arista/ultranetMonitor/ui-tile-1/ui-tile-kicad/ui-tile-kicad.kicad_pcb

## KiCad design ui-tile-1/ui-tile-kicad/ui-tile-kicad.kicad_pcb (2026-06-21)

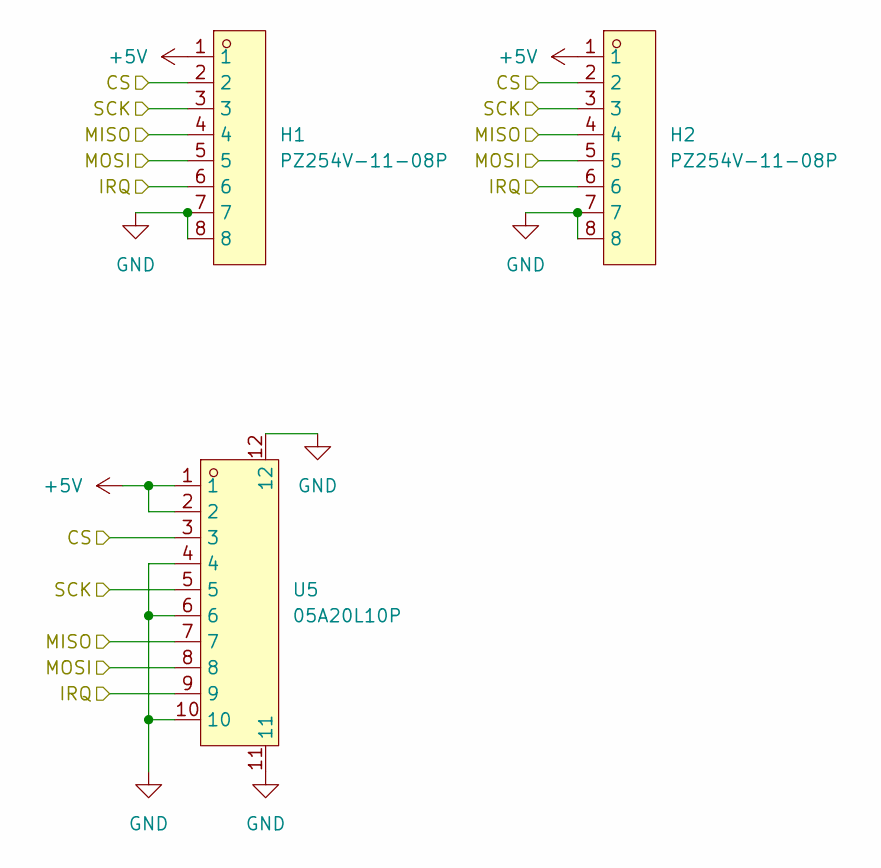
[picture p1: schematic headers.kicad_sch]

Parts:
H1, H2: PZ254V-11-08P; HDR-TH_8P-P2.54-V-M; MPN PZ254V-11-08P; LCSC Part C492407
U5: 05A20L10P; FPC-SMD_10P-P0.50_05A20L10P; MPN 05A20L10P; LCSC Part C5362154

Connections:
+5V: H1.1, H2.1, U5.1, U5.2; also elsewhere on the board
/headers/CS: H1.2, H2.2, U5.3; also elsewhere on the board
/headers/IRQ: H1.6, H2.6, U5.9; also elsewhere on the board
/headers/MISO: H1.4, H2.4, U5.7; also elsewhere on the board
/headers/MOSI: H1.5, H2.5, U5.8; also elsewhere on the board
/headers/SCK: H1.3, H2.3, U5.5; also elsewhere on the board
GND: H1.7, H1.8, H2.7, H2.8, U5.4, U5.6, U5.10, U5.11, U5.12; also elsewhere on the board

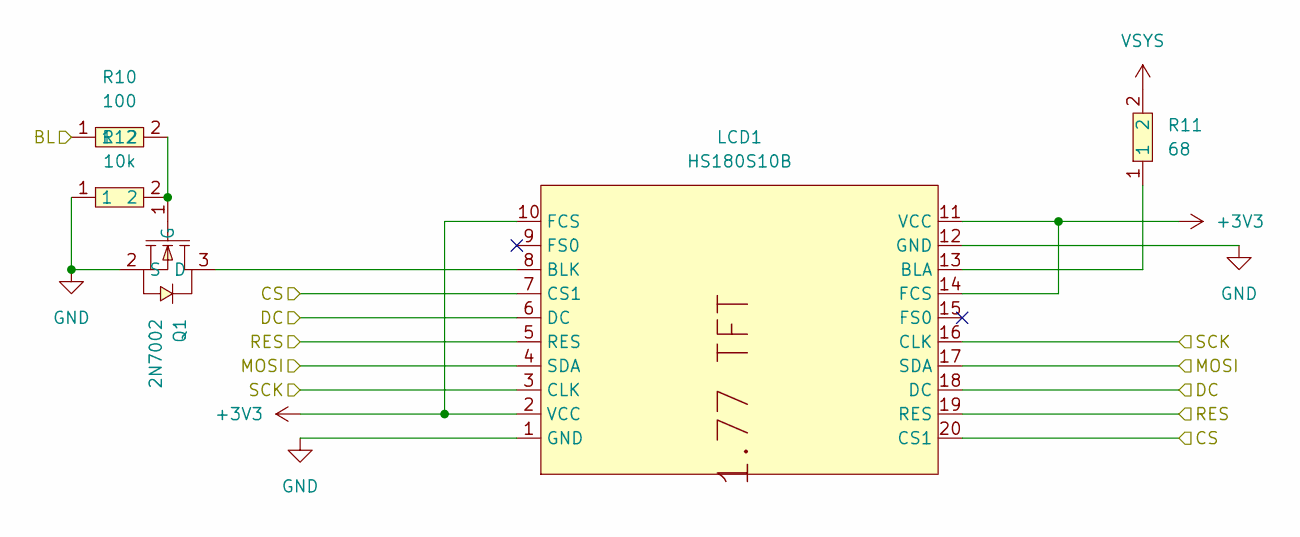
[picture p2: schematic lcd.kicad_sch]

Parts:
LCD1: HS180S10B; LCD-TH_L56.0-W35.0-P2.54_HS180S10B; MPN HS180S10B; LCSC Part C5329585
Q1: 2N7002; SOT-23-3_L2.9-W1.3-P1.90-LS2.4-BR; MPN 2N7002; LCSC Part C8545
R10: 100; R0402; MPN 0402WGF1000TCE; LCSC Part C25076
R11: 68; R0603; MPN 0603WAF680JT5E; LCSC Part C27592
R12: 10k; R0402; MPN 0402WGF1002TCE; LCSC Part C25744

Connections:
+3V3: LCD1.2 (VCC), LCD1.10 (FCS), LCD1.11 (VCC), LCD1.14 (FCS); also elsewhere on the board
/lcd/BL: R10.1; also elsewhere on the board
/lcd/CS: LCD1.7 (CS1), LCD1.20 (CS1); also elsewhere on the board
/lcd/DC: LCD1.6 (DC), LCD1.18 (DC); also elsewhere on the board
/lcd/MOSI: LCD1.4 (SDA), LCD1.17 (SDA); also elsewhere on the board
/lcd/RES: LCD1.5 (RES), LCD1.19 (RES); also elsewhere on the board
/lcd/SCK: LCD1.3 (CLK), LCD1.16 (CLK); also elsewhere on the board
GND: LCD1.1 (GND), LCD1.12 (GND), Q1.2 (S), R12.1; also elsewhere on the board
unnamed: LCD1.13 (BLA), R11.1
unnamed: LCD1.8 (BLK), Q1.3 (D)
unnamed: Q1.1 (G), R10.2, R12.2
VSYS: R11.2; also elsewhere on the board

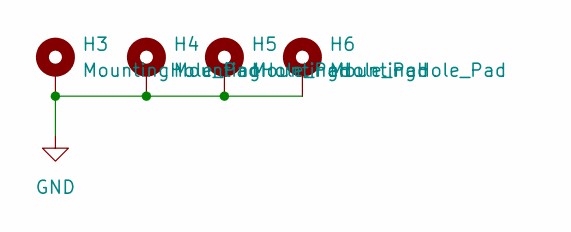
[picture p3: schematic mounting_holes.kicad_sch]

Parts:
H3, H4, H5, H6: MountingHole_Pad; MountingHole_3.2mm_M3_Pad

Connections:
GND: H3.1 (1_1), H4.1 (1_1), H5.1 (1_1), H6.1 (1_1); also elsewhere on the board

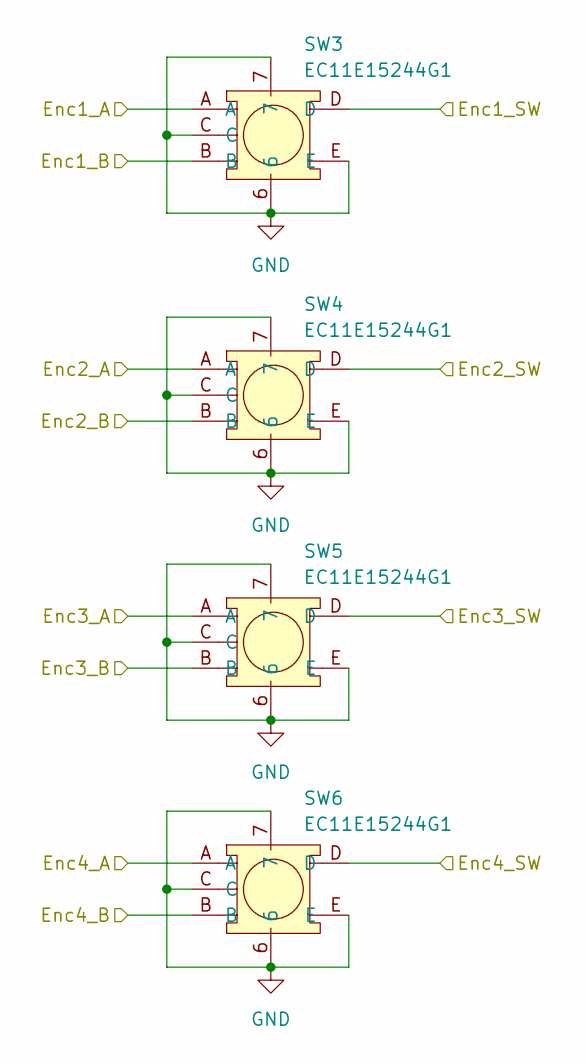
[picture p4: schematic encoders.kicad_sch]

Parts:
SW3, SW4, SW5, SW6: EC11E15244G1; SW-TH_EC11E15244G1; MPN EC11E15244G1; LCSC Part C370970

Connections:
/encoders/Enc1_A: SW3.A; also elsewhere on the board
/encoders/Enc1_B: SW3.B; also elsewhere on the board
/encoders/Enc1_SW: SW3.D; also elsewhere on the board
/encoders/Enc2_A: SW4.A; also elsewhere on the board
/encoders/Enc2_B: SW4.B; also elsewhere on the board
/encoders/Enc2_SW: SW4.D; also elsewhere on the board
/encoders/Enc3_A: SW5.A; also elsewhere on the board
/encoders/Enc3_B: SW5.B; also elsewhere on the board
/encoders/Enc3_SW: SW5.D; also elsewhere on the board
/encoders/Enc4_A: SW6.A; also elsewhere on the board
/encoders/Enc4_B: SW6.B; also elsewhere on the board
/encoders/Enc4_SW: SW6.D; also elsewhere on the board
GND: SW3.6, SW3.7, SW3.C, SW3.E, SW4.6, SW4.7, SW4.C, SW4.E, SW5.6, SW5.7, SW5.C, SW5.E, SW6.6, SW6.7, SW6.C, SW6.E; also elsewhere on the board

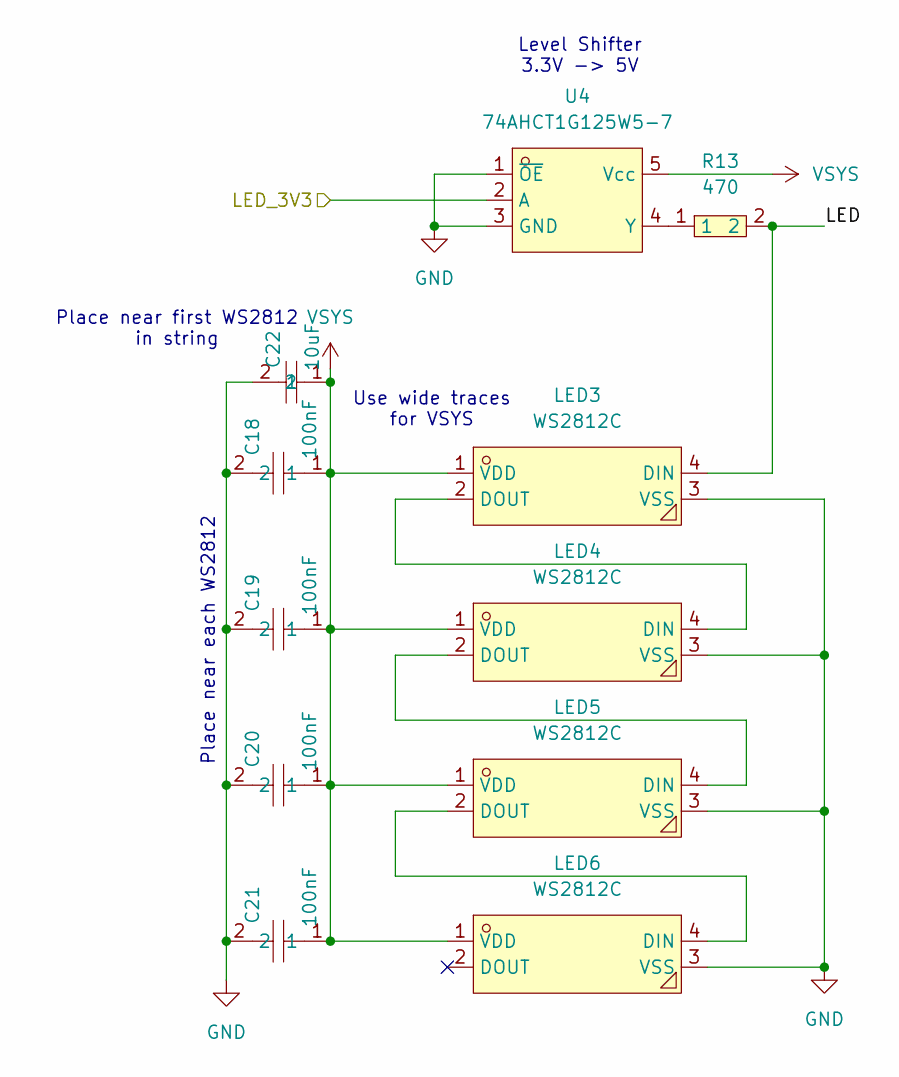
[picture p5: schematic leds.kicad_sch]

Parts:
C18, C19, C20, C21: 100nF; C0402; MPN CL05B104KO5NNNC; LCSC Part C1525
C22: 10uF; C0805; MPN CL21A106KOQNNNE; LCSC Part C1713
LED3, LED4, LED5, LED6: WS2812C; LED-SMD_4P-L5.0-W5.0-LS5.4-TL-1; MPN WS2812C; LCSC Part C114587
R13: 470; R0402; MPN 0402WGF4700TCE; LCSC Part C25117
U4: 74AHCT1G125W5-7; SOT-25-5_L3.0-W1.6-P0.95-LS2.8-BL; MPN 74AHCT1G125W5-7; LCSC Part C842287

Connections:
/leds/LED: LED3.4 (DIN), R13.2
/leds/LED_3V3: U4.2 (A); also elsewhere on the board
GND: C18.2, C19.2, C20.2, C21.2, C22.2, LED3.3 (VSS), LED4.3 (VSS), LED5.3 (VSS), LED6.3 (VSS), U4.1 (~OE), U4.3 (GND); also elsewhere on the board
unnamed: LED3.2 (DOUT), LED4.4 (DIN)
unnamed: LED4.2 (DOUT), LED5.4 (DIN)
unnamed: LED5.2 (DOUT), LED6.4 (DIN)
unnamed: R13.1, U4.4 (Y)
VSYS: C18.1, C19.1, C20.1, C21.1, C22.1, LED3.1 (VDD), LED4.1 (VDD), LED5.1 (VDD), LED6.1 (VDD), U4.5 (Vcc); also elsewhere on the board

Notes on the sheet:
Place near first WS2812 in string
Place near each WS2812
Use wide traces for VSYS
Level Shifter 3.3V -> 5V

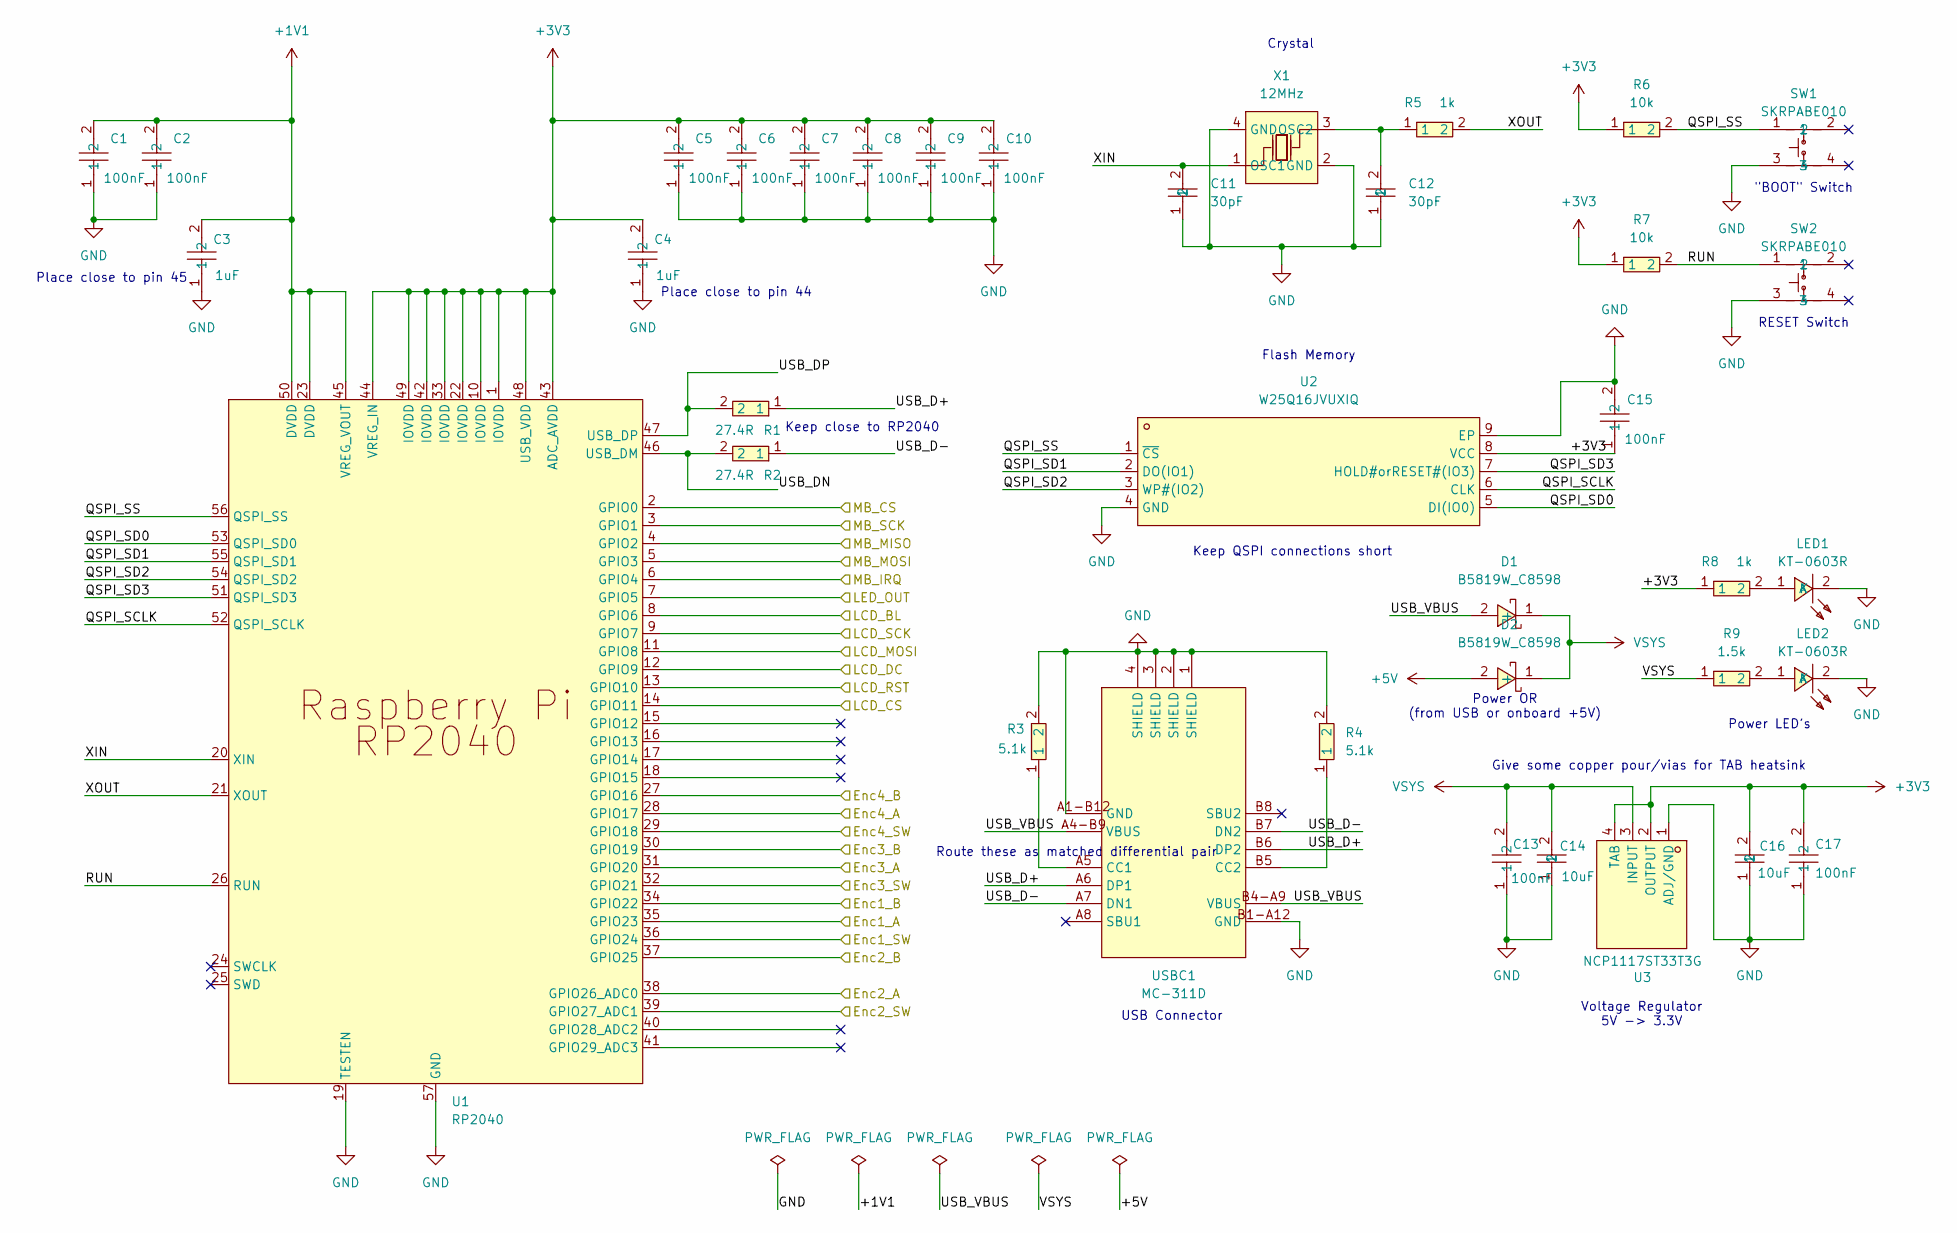
[picture p6: schematic rp2040.kicad_sch]

Parts:
C1, C2, C5, C6, C7, C8, C9, C10, C13, C15, C17: 100nF; C0402; MPN CL05B104KO5NNNC; LCSC Part C1525
C3, C4: 1uF; C0402; MPN CL05A105KA5NQNC; LCSC Part C52923
C11, C12: 30pF; C0402; MPN 0402CG300J500NT; LCSC Part C1570
C14, C16: 10uF; C0805; MPN CL21A106KOQNNNE; LCSC Part C1713
D1, D2: B5819W_C8598; SOD-123_L2.7-W1.6-LS3.7-RD-1; MPN B5819W SL; LCSC Part C8598
LED1, LED2: KT-0603R; LED-SMD_L1.6-W0.8-R-RD; MPN KT-0603R; LCSC Part C2286
R1, R2: 27.4R; R0402; MPN 0402WGF274JTCE; LCSC Part C31439
R3, R4: 5.1k; R0402; MPN 0402WGF5101TCE; LCSC Part C25905
R5, R8: 1k; R0402; MPN 0402WGF1001TCE; LCSC Part C11702
R6, R7: 10k; R0402; MPN 0402WGF1002TCE; LCSC Part C25744
R9: 1.5k; R0603; MPN 0603WAF1501T5E; LCSC Part C22843
SW1, SW2: SKRPABE010; KEY-SMD_4P-L4.2-W3.2-P2.20-LS4.6; MPN SKRPABE010; LCSC Part C115360
U1: RP2040; LQFN-56_L7.0-W7.0-P0.4-EP; MPN RP2040; LCSC Part C2040
U2: W25Q16JVUXIQ; USON-8_L3.0-W2.0-P0.50-BL-EP; MPN W25Q16JVUXIQ; LCSC Part C2843335
U3: NCP1117ST33T3G; SOT-223-3_L6.5-W3.4-P2.30-LS7.0-BR; MPN NCP1117ST33T3G; LCSC Part C26537
USBC1: MC-311D; USB-C-SMD_MC-311D; MPN MC-311D; LCSC Part C136423
X1: 12MHz; CRYSTAL-SMD_4P-L3.2-W2.5-BL; MPN X322512MSB4SI; LCSC Part C9002

Connections:
+1V1: C1.2, C2.2, C3.2, U1.23 (DVDD), U1.45 (VREG_VOUT), U1.50 (DVDD)
+3V3: C4.2, C5.2, C6.2, C7.2, C8.2, C9.2, C10.2, C15.1, C16.2, C17.2, R6.1, R7.1, R8.1, U1.1 (IOVDD), U1.10 (IOVDD), U1.22 (IOVDD), U1.33 (IOVDD), U1.42 (IOVDD), U1.43 (ADC_AVDD), U1.44 (VREG_IN), U1.48 (USB_VDD), U1.49 (IOVDD), U2.8 (VCC), U3.2 (OUTPUT), U3.4 (TAB); also elsewhere on the board
+5V: D2.2 (+); also elsewhere on the board
/encoders/Enc1_A: U1.35 (GPIO23); also elsewhere on the board
/encoders/Enc1_B: U1.34 (GPIO22); also elsewhere on the board
/encoders/Enc1_SW: U1.36 (GPIO24); also elsewhere on the board
/encoders/Enc2_A: U1.38 (GPIO26_ADC0); also elsewhere on the board
/encoders/Enc2_B: U1.37 (GPIO25); also elsewhere on the board
/encoders/Enc2_SW: U1.39 (GPIO27_ADC1); also elsewhere on the board
/encoders/Enc3_A: U1.31 (GPIO20); also elsewhere on the board
/encoders/Enc3_B: U1.30 (GPIO19); also elsewhere on the board
/encoders/Enc3_SW: U1.32 (GPIO21); also elsewhere on the board
/encoders/Enc4_A: U1.28 (GPIO17); also elsewhere on the board
/encoders/Enc4_B: U1.27 (GPIO16); also elsewhere on the board
/encoders/Enc4_SW: U1.29 (GPIO18); also elsewhere on the board
/headers/CS: U1.2 (GPIO0); also elsewhere on the board
/headers/IRQ: U1.6 (GPIO4); also elsewhere on the board
/headers/MISO: U1.4 (GPIO2); also elsewhere on the board
/headers/MOSI: U1.5 (GPIO3); also elsewhere on the board
/headers/SCK: U1.3 (GPIO1); also elsewhere on the board
/lcd/BL: U1.8 (GPIO6); also elsewhere on the board
/lcd/CS: U1.14 (GPIO11); also elsewhere on the board
/lcd/DC: U1.12 (GPIO9); also elsewhere on the board
/lcd/MOSI: U1.11 (GPIO8); also elsewhere on the board
/lcd/RES: U1.13 (GPIO10); also elsewhere on the board
/lcd/SCK: U1.9 (GPIO7); also elsewhere on the board
/leds/LED_3V3: U1.7 (GPIO5); also elsewhere on the board
/rp2040/QSPI_SCLK: U1.52 (QSPI_SCLK), U2.6 (CLK)
/rp2040/QSPI_SD0: U1.53 (QSPI_SD0), U2.5 (DI(IO0))
/rp2040/QSPI_SD1: U1.55 (QSPI_SD1), U2.2 (DO(IO1))
/rp2040/QSPI_SD2: U1.54 (QSPI_SD2), U2.3 (WP#(IO2))
/rp2040/QSPI_SD3: U1.51 (QSPI_SD3), U2.7 (HOLD#orRESET#(IO3))
/rp2040/QSPI_SS: R6.2, SW1.1, U1.56 (QSPI_SS), U2.1 (~CS)
/rp2040/RUN: R7.2, SW2.1, U1.26 (RUN)
/rp2040/USB_D+: R1.1, USBC1.A6 (DP1), USBC1.B6 (DP2)
/rp2040/USB_D-: R2.1, USBC1.A7 (DN1), USBC1.B7 (DN2)
/rp2040/USB_DN: R2.2, U1.46 (USB_DM)
/rp2040/USB_DP: R1.2, U1.47 (USB_DP)
/rp2040/USB_VBUS: D1.2 (+), USBC1.A4-B9 (VBUS), USBC1.B4-A9 (VBUS)
/rp2040/XIN: C11.2, U1.20 (XIN), X1.1 (OSC1)
/rp2040/XOUT: R5.2, U1.21 (XOUT)
GND: C1.1, C2.1, C3.1, C4.1, C5.1, C6.1, C7.1, C8.1, C9.1, C10.1, C11.1, C12.1, C13.1, C14.1, C15.2, C16.1, C17.1, LED1.2 (K), LED2.2 (K), R3.2, R4.2, SW1.3, SW2.3, U1.19 (TESTEN), U1.57 (GND), U2.4 (GND), U2.9 (EP), U3.1 (ADJ/GND), USBC1.1 (SHIELD), USBC1.2 (SHIELD), USBC1.3 (SHIELD), USBC1.4 (SHIELD), USBC1.A1-B12 (GND), USBC1.B1-A12 (GND), X1.2 (GND), X1.4 (GND); also elsewhere on the board
unnamed: LED1.1 (A), R8.2
unnamed: LED2.1 (A), R9.2
unnamed: R3.1, USBC1.A5 (CC1)
unnamed: R4.1, USBC1.B5 (CC2)
unnamed: C12.2, R5.1, X1.3 (OSC2)
VSYS: C13.2, C14.2, D1.1 (-), D2.1 (-), R9.1, U3.3 (INPUT); also elsewhere on the board

Notes on the sheet:
Route these as matched differential pair
Give some copper pour/vias for TAB heatsink
Crystal
RESET Switch
"BOOT" Switch
Flash Memory
Place close to pin 45
Voltage Regulator 5V -> 3.3V
Keep QSPI connections short
Keep close to RP2040
Power LED's
Power OR (from USB or onboard +5V)
USB Connector
Place close to pin 44

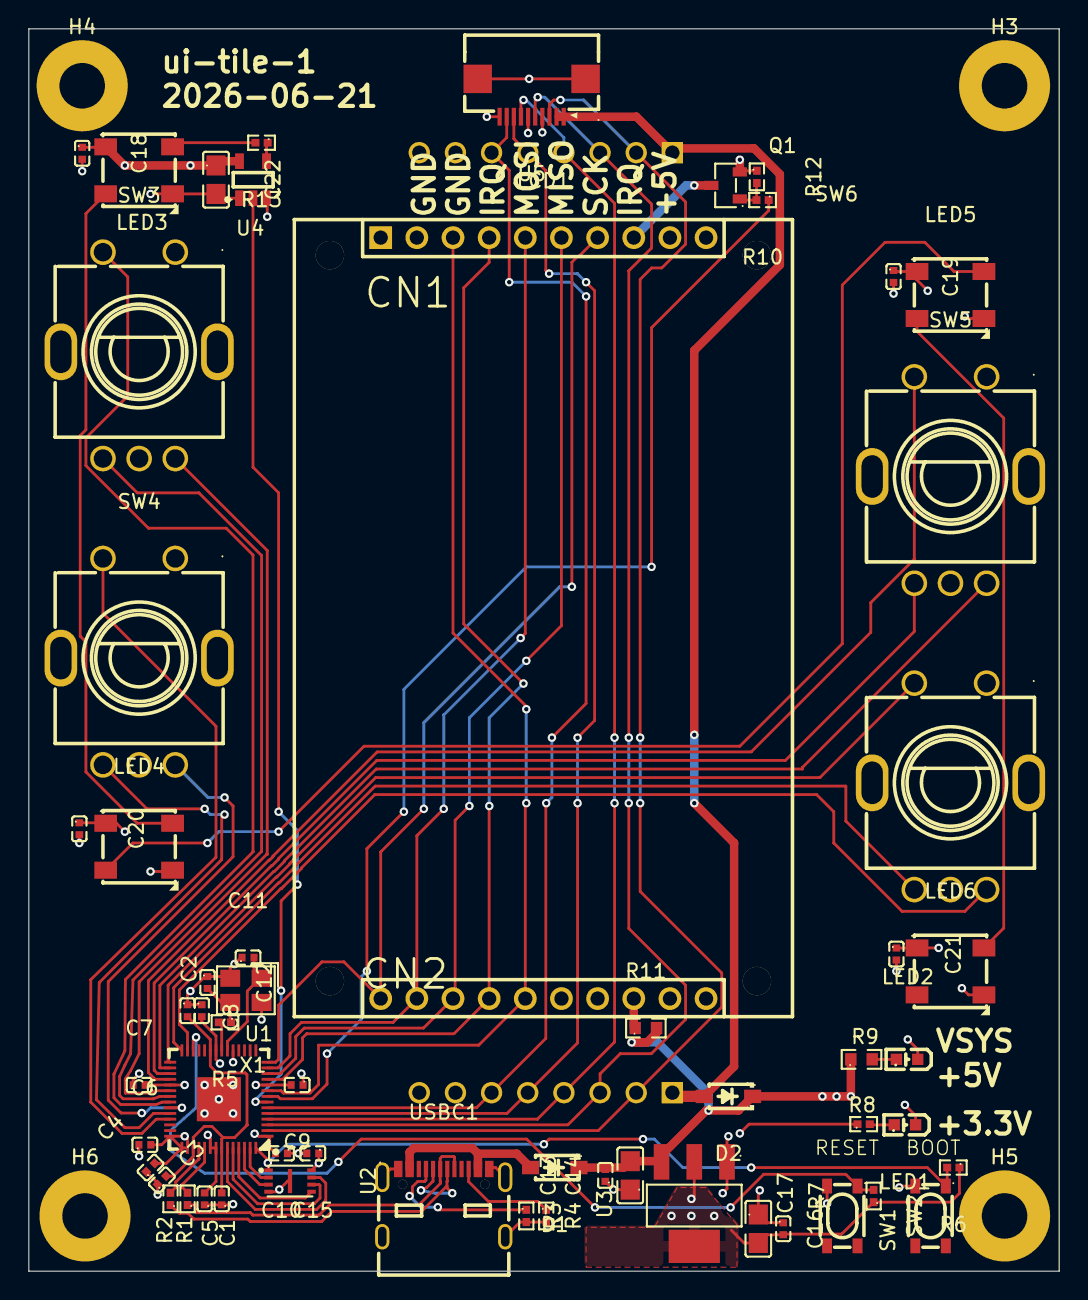
[picture p7: board ui-tile-kicad.kicad_pcb from above]

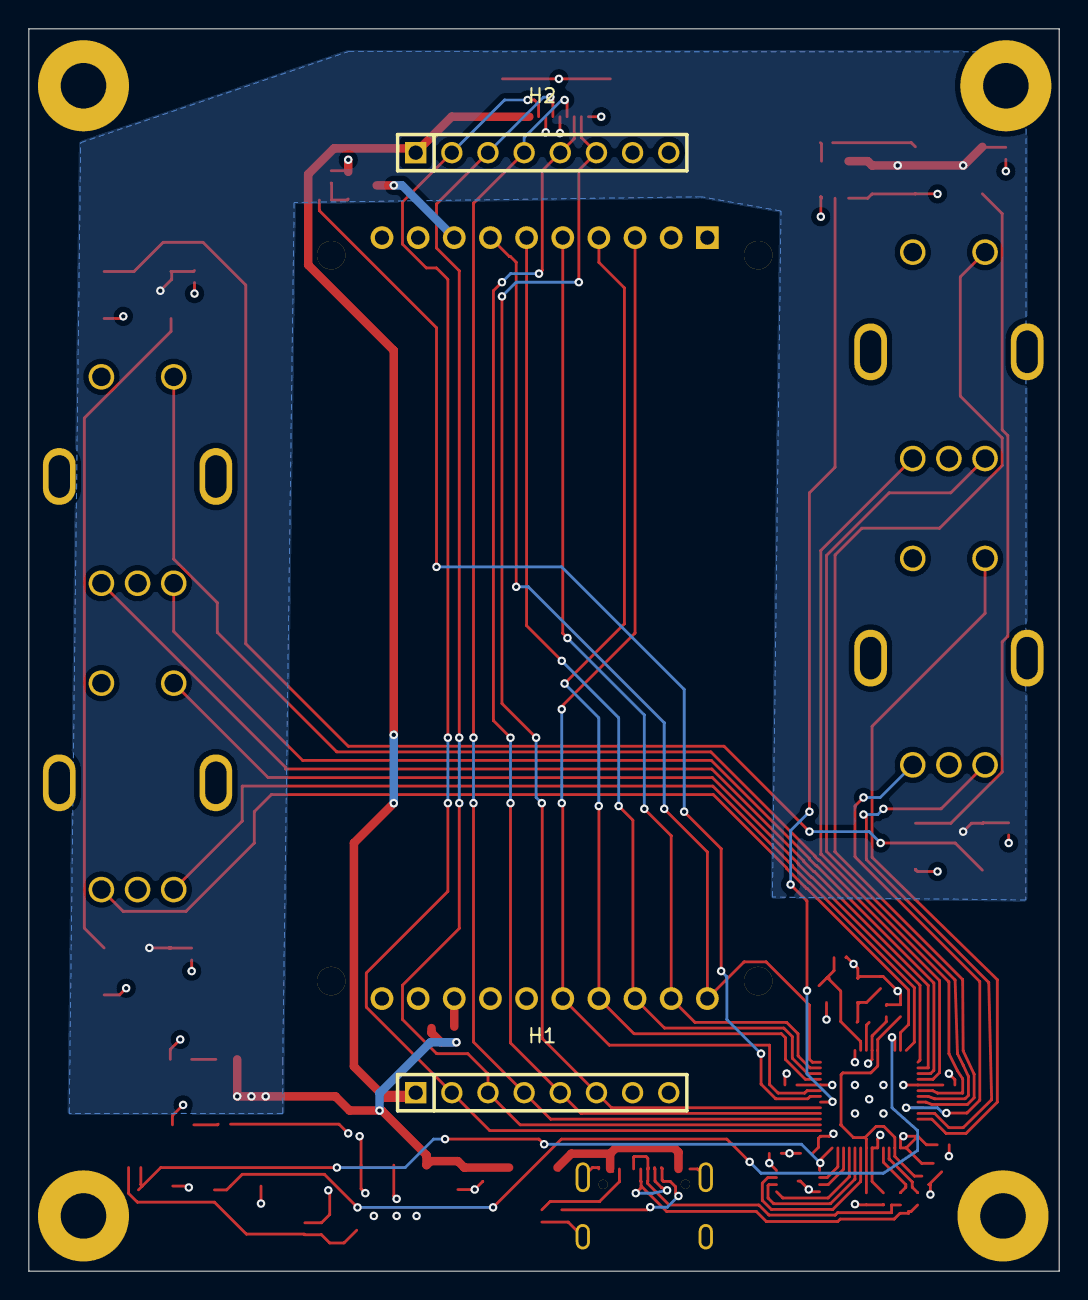
[picture p8: board ui-tile-kicad.kicad_pcb from below]

Board: 4 copper layers, 72.4 x 87.3 mm, 64 parts (2 on the bottom side), 56 nets.
