arista/ultranetMonitor/(commit log)

2026-06-15 Add KiCad setup plan, install script, and next-steps
    Document the decision to run KiCad in-container via WSLg, add an
    install-kicad script (KiCad 9 + easyeda2kicad via pipx) following the
    existing COPY+RUN convention, and record next steps in PLANS.md.
2026-06-16 Update KiCad docs: GPU passthrough via compose, mark build done
    Convert the GPU-acceleration section to docker compose form (mount
    /dev + /usr/lib/wsl, set LD_LIBRARY_PATH) reflecting the actual run
    setup, and flag the missing /usr/lib/wsl mount as the cause of the
    llvmpipe fallback. Check off the Dockerfile/build steps now that the
    container builds with KiCad included.
2026-06-16 Record GPU-accel troubleshooting state (paused for WSL restart)
    Root cause is host-side: WSL itself has no GPU OpenGL (host glxinfo
    ZINK/drisw failures, vulkaninfo only software). Container wiring is
    correct. Next steps after wsl --update / GPU driver update captured
    for resume.
2026-06-16 Pin GPU-accel: wsl --update fixed host GL; d3d12 works in container, decision deferred
    Host hardware GL (D3D12 / AMD 860M) came back from wsl --update to 2.7.8.0
    alone, no vendor driver needed. Container defaults to llvmpipe but
    GALLIUM_DRIVER=d3d12 switches it to hardware. Deferring whether to enable
    it until there's a real KiCad board to judge the present-readback tradeoff
    (glxgears regresses; heavy scenes expected to win). Resume steps captured.
2026-06-16 Add kicad-shared library setup checklist to PLANS
    Expand step 5 into an ordered checklist: create kicad-shared repo with
    easyeda2kicad-aligned layout (jlcpcb.kicad_sym/.pretty/.3dshapes), define
    KICAD_USER_LIB as a container env var, add lib-table entries referencing
    the var, and verify 3D-model paths resolve via the var. Update step 6 test
    to use the shared lib base name.
2026-06-16 removed install-kicad
2026-06-16 Move general KiCad setup docs to kicad-shared repo
    kicad-startup.md and the KiCad setup content of PLANS.md now live in the
    sibling kicad-shared repo. PLANS.md reset to an ultranetMonitor project stub.
2026-06-19 started on ui tile schematic
    [ui-tile-kicad.kicad_pcb, ui-tile-kicad.kicad_sch]
2026-06-19 continuing with ui-tile
    [ui-tile-kicad.kicad_pcb, ui-tile-kicad.kicad_sch]
2026-06-19 removed warnings from schematic
    [ui-tile-kicad.kicad_pcb, ui-tile-kicad.kicad_sch]
2026-06-19 finished first pass at rp2040 basics
    [ui-tile-kicad.kicad_pcb, ui-tile-kicad.kicad_sch]
2026-06-19 started breaking out into sub sheets
    [encoders.kicad_sch, lcd.kicad_sch, rp2040.kicad_sch, ui-tile-kicad.kicad_pcb, ui-tile-kicad.kicad_sch, untitled.kicad_sch]
2026-06-19 started on ws2812's
    [encoders.kicad_sch, lcd.kicad_sch, rp2040.kicad_sch, ui-tile-kicad.kicad_pcb]
2026-06-20 finished schematic electricals
    [encoders.kicad_sch, headers.kicad_sch, lcd.kicad_sch, leds.kicad_sch, rp2040.kicad_sch, ui-tile-kicad.kicad_pcb, ui-tile-kicad.kicad_sch]
2026-06-20 preparing for pcb layout
    [ui-tile-kicad.kicad_pcb]
2026-06-20 brought in erc fixes
    [encoders.kicad_sch, lcd.kicad_sch, leds.kicad_sch]
2026-06-20 progress on pcb layout
    [rp2040.kicad_sch, ui-tile-kicad.kicad_pcb]
2026-06-21 finished first pass of pcb layout
    [rp2040.kicad_sch, ui-tile-kicad.kicad_pcb]
2026-06-21 moved regulator away from board edge
    [ui-tile-kicad.kicad_pcb]
2026-06-21 Added mounting holes
    [mounting_holes.kicad_sch, ui-tile-kicad.kicad_pcb, ui-tile-kicad.kicad_sch]
2026-06-21 added fpc connector
    [headers.kicad_sch, mounting_holes.kicad_sch, ui-tile-kicad.kicad_pcb]
2026-06-21 added some labeling
    [ui-tile-kicad.kicad_pcb]
2026-06-21 marked the two headers as exclude from position files and exclude from bill of materials
    [ui-tile-kicad.kicad_pcb]
2026-06-21 snapshot of the board ordered from jlcpcb - ui-tile-1 2026-06-21
    [bom.csv, designators.csv, positions.csv]
2026-06-21 docs: record JLCPCB fabrication workflow
    Ignore the plugin's live production/ output; document the
    copy-to-production-YYYY-MM-DD/ archive convention in PLANS, plus the
    fab/order notes (LCSC fields, H1/H2 exclusion, THT parts, WS2812
    forces Standard assembly).
